Kirill-Kasparov/Plants_monitor/Распиновка.JPG

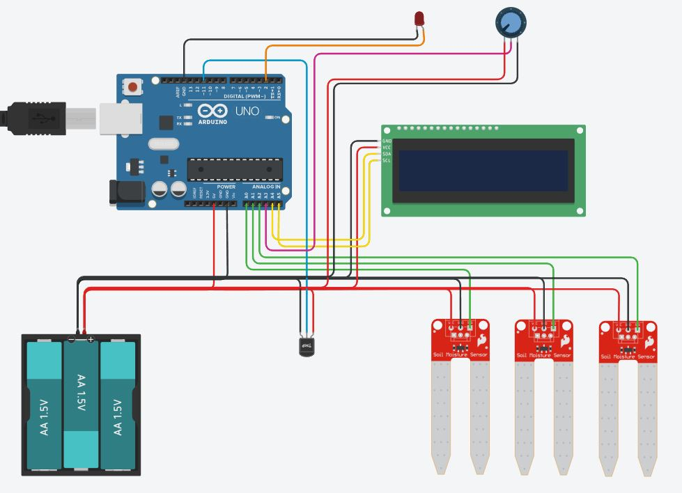
Распиновка.JPG
